fyrus7/FyrusDigitalAlarmClock/DS3231_SQW_Alarm_Clock_FYRUS.ino

const unsigned char PROGMEM FSufi2 [] = {
  0xff, 0xff, 0xff, 0xff, 0xff, 0xf8, 0xff, 0xff, 0xff, 0xff, 0xff, 0xf8, 0xff, 0xff, 0xff, 0xff, 
  0xff, 0xf8, 0xe0, 0x00, 0x00, 0x00, 0x00, 0x38, 0xe0, 0x00, 0x00, 0x00, 0x00, 0x38, 0xe0, 0x00, 
  0x00, 0x00, 0x00, 0x38, 0xe3, 0x8e, 0x3f, 0xe3, 0x8e, 0x38, 0xe3, 0x8e, 0x3f, 0xe3, 0x8e, 0x38, 
  0xe3, 0x8e, 0x3f, 0xe3, 0x8e, 0x38, 0xe3, 0x80, 0x00, 0x00, 0x00, 0x38, 0xe3, 0x80, 0x00, 0x00, 
  0x00, 0x38, 0xe3, 0x80, 0x00, 0x00, 0x00, 0x38, 0xe3, 0x8e, 0x3f, 0xe3, 0xfe, 0x38, 0xe3, 0x8e, 
  0x3f, 0xe3, 0xfe, 0x38, 0xe3, 0x8e, 0x3f, 0xe3, 0xfe, 0x38, 0xe3, 0x8e, 0x38, 0xe3, 0x8e, 0x38, 
  0xe3, 0x8e, 0x38, 0xe3, 0x8e, 0x38, 0xe3, 0x8e, 0x38, 0xe3, 0x8e, 0x38, 0xe3, 0x8e, 0x3f, 0xe3, 
  0xfe, 0x38, 0xe3, 0x8e, 0x3f, 0xe3, 0xfe, 0x38, 0xe3, 0x8e, 0x3f, 0xe3, 0xfe, 0x38, 0xe3, 0x8e, 
  0x00, 0xe0, 0x0e, 0x38, 0xe3, 0x8e, 0x00, 0xe0, 0x0e, 0x38, 0xe3, 0x8e, 0x00, 0xe0, 0x0e, 0x38, 
  0xe3, 0x8e, 0x3f, 0xe3, 0x8e, 0x38, 0xe3, 0x8e, 0x3f, 0xe3, 0x8e, 0x38, 0xe3, 0x8e, 0x3f, 0xe3, 
  0x8e, 0x38, 0xe3, 0x8e, 0x00, 0x03, 0x8e, 0x38, 0xe3, 0x8e, 0x00, 0x03, 0x8e, 0x38, 0xe3, 0x8e, 
  0x00, 0x03, 0x8e, 0x38, 0xe3, 0x8e, 0x3f, 0xff, 0xfe, 0x38, 0xe3, 0x8e, 0x3f, 0xff, 0xfe, 0x38, 
  0xe3, 0x8e, 0x3f, 0xff, 0xfe, 0x38, 0xe3, 0x80, 0x00, 0xe0, 0x00, 0x38, 0xe3, 0x80, 0x00, 0xe0, 
  0x00, 0x38, 0xe3, 0x80, 0x00, 0xe0, 0x00, 0x38, 0xe3, 0xff, 0xff, 0xe3, 0x8e, 0x38, 0xe3, 0xff, 
  0xff, 0xe3, 0x8e, 0x38, 0xe3, 0xff, 0xff, 0xe3, 0x8e, 0x38, 0xe0, 0x00, 0x00, 0x00, 0x00, 0x38, 
  0xe0, 0x00, 0x00, 0x00, 0x00, 0x38, 0xe0, 0x00, 0x00, 0x00, 0x00, 0x38, 0xff, 0xff, 0xff, 0xff, 
  0xff, 0xf8, 0xff, 0xff, 0xff, 0xff, 0xff, 0xf8, 0xff, 0xff, 0xff, 0xff, 0xff, 0xf8
};

// 'Select_Top', 5x3px
const unsigned char Select_Top [] PROGMEM = {
  0x20, 0x70, 0xf8
};

// 'Select_Side', 3x5px
const unsigned char Select_Side [] PROGMEM = {
  0x80, 0xc0, 0xe0, 0xc0, 0x80
};

// 'Select_Buttom', 5x3px
const unsigned char Select_Buttom [] PROGMEM = {
  0xf8, 0x70, 0x20
};


#include "RTClib.h"
#include <TimerOne.h>
#include <LowPower.h>
#include <Adafruit_SSD1306.h>

RTC_DS3231 rtc;

Adafruit_SSD1306 display(128, 64, &Wire, -1);

byte _day, _month, _hour24, _hour12, _minute, _second, _dtw;
int _year;
byte hr24;
char st[2];
char _nameoftheDay[9];
char _monthsName[3];

const char daysOfTheWeek_0[] PROGMEM = "Sunday";   
const char daysOfTheWeek_1[] PROGMEM = "Monday";
const char daysOfTheWeek_2[] PROGMEM = "Tuesday";
const char daysOfTheWeek_3[] PROGMEM = "Wednesday";
const char daysOfTheWeek_4[] PROGMEM = "Thursday";
const char daysOfTheWeek_5[] PROGMEM = "Friday";
const char daysOfTheWeek_6[] PROGMEM = "Saturday";

const char* const daysOfTheWeek_table[] PROGMEM = {
  daysOfTheWeek_0,
  daysOfTheWeek_1,
  daysOfTheWeek_2,
  daysOfTheWeek_3,
  daysOfTheWeek_4,
  daysOfTheWeek_5,
  daysOfTheWeek_6};

const char months_name_0[] PROGMEM = "Jan";   
const char months_name_1[] PROGMEM = "Feb";
const char months_name_2[] PROGMEM = "Mar";
const char months_name_3[] PROGMEM = "Apr";
const char months_name_4[] PROGMEM = "May";
const char months_name_5[] PROGMEM = "Jun";
const char months_name_6[] PROGMEM = "Jul";
const char months_name_7[] PROGMEM = "Aug";
const char months_name_8[] PROGMEM = "Sep";
const char months_name_9[] PROGMEM = "Oct";
const char months_name_10[] PROGMEM = "Nov";
const char months_name_11[] PROGMEM = "Dec";

const char* const months_name_table[] PROGMEM = {
  months_name_0, months_name_1, months_name_2, months_name_3,
  months_name_4, months_name_5, months_name_6, months_name_7,
  months_name_8, months_name_9, months_name_10, months_name_11,};

//--> Variables for Buttons
byte btn_Select, btn_Down;

//--> Variable for SQW pin
const int sqwPin = 2;

//--> Variable for Buzzer
byte Buzzer = 5;
        


// Variables for Menus
bool Menu_Stat = false;
byte Menu_Cnt = 0;
bool Menu_Set = false;
byte Menu_Set_cnt;
byte Menu_Set_TimeDate = 0;

bool set_Hour = false;
bool set_Minute = false;
bool set_Day = false;
bool set_Month = false;
bool set_Year = false;

bool blink_cursor = false;
int _delay = 100;

// Alarm 1
byte Alarm_Stat = 0;
bool Set_hour_alarm = false;
bool Set_minute_alarm = false;
byte Menu_Set_Alarm = 0;
bool Alarm_Sound = false;
bool Alarm_Start = false;
byte Alarm_Duration = 0;
bool Blink_Alarm_Display = false;

// Alarm 2
byte Alarm_Stat2 = 0;
bool Set_hour_alarm2 = false;
bool Set_minute_alarm2 = false;
byte Menu_Set_Alarm2 = 0;
bool Alarm_Sound2 = false;
bool Alarm_Start2 = false;
byte Alarm_Duration2 = 0;
bool Blink_Alarm_Display2 = false;


// Variables for Millis to update Time and Date. Also for the Alarm interval
unsigned long previousMillisGetTimeDate = 0; //--> will store last time was updated
const long intervalGetTimeDate = 1000; //--> interval (milliseconds) 


const unsigned long sleepTimeout = 15000; // 15 second to sleep mode
volatile unsigned long lastActivityTime = 0; // Declare as volatile for ISR safety
const int CRT_display = 300; // CRT Off Animation duration in milliseconds


void wakeUp(){
  // let this empty
}

void timerISR() {
  // let this empty
}


void setup() {
  //Serial.begin(9600);

  pinMode(3, INPUT_PULLUP);
  pinMode(6, INPUT_PULLUP);
  pinMode(sqwPin, INPUT_PULLUP);

  pinMode(Buzzer, OUTPUT);

  rtc.begin();
/*
  if (! rtc.begin()) {
   // Serial.println("Couldn't find RTC");
   // Serial.flush();
    while (1);
  }*/
/*
  if (rtc.lostPower()) {
   // Serial.println("RTC lost power, let's set the time!");
   // rtc.adjust(DateTime(F(__DATE__), F(__TIME__)));
  }*/


  rtc.disable32K(); // disable 32K Pin

  rtc.disableAlarm(1);
  rtc.disableAlarm(2);
  rtc.clearAlarm(1);
  rtc.clearAlarm(2);

  rtc.writeSqwPinMode(DS3231_OFF); // Place SQW pin into alarm interrupt mode

  display.begin(SSD1306_SWITCHCAPVCC, 0x3C);
  display.clearDisplay();

  display.drawBitmap(3, 10, FSufi2, 45, 45, WHITE);
  display.setTextColor(WHITE);
  display.setTextSize(1);
  display.setCursor(55, 10);
  display.print(F("== FYRUS =="));
  display.setCursor(55, 38);
  display.print(F("DS3231 RTC"));
  display.setCursor(55, 48);
  display.print(F("Alarm Clock"));

  display.display();
  delay(3000);

  // Set up TimerOne to call the timerISR function every 1 second
  Timer1.initialize(1000000); // 1 second interval
  Timer1.attachInterrupt(timerISR);

}


void loop() {

  
  // To update the Time and Date
  unsigned long currentMillisGetTimeDate = millis();
  if (currentMillisGetTimeDate - previousMillisGetTimeDate >= intervalGetTimeDate) {
    // save the last time you blinked the LED
    previousMillisGetTimeDate = currentMillisGetTimeDate;

    // Time and Date are displayed if Menu Status = False
    if (Menu_Stat == false) {
      GetDateTime();
 

      display.clearDisplay();


      if (Alarm_Stat == 1 && Alarm_Stat2 == 1){
        Alarm_Start = true;
        Alarm_Start2 = true;

        display.setCursor(85, 0);
        DateTime alarmTime = rtc.getAlarm1();

        display.write(0x0E); display.print(F(" "));

        if (alarmTime.hour() < 10) {
          display.print(F("0"));
          display.print(alarmTime.hour());
        } else {
          display.print(alarmTime.hour());
        }
          display.print(F(":"));
        if (alarmTime.minute() < 10) {
          display.print(F("0"));
          display.print(alarmTime.minute());
        } else {
          display.print(alarmTime.minute());
        }

        display.setCursor(2, 56);
        DateTime alarmTime2 = rtc.getAlarm2();

        display.write(0x0E); display.print(F(" "));

        if (alarmTime2.hour() < 10) {
          display.print(F("0"));
          display.print(alarmTime2.hour());
        } else {
          display.print(alarmTime2.hour());
        }
          display.print(F(":"));
        if (alarmTime2.minute() < 10) {
          display.print(F("0"));
          display.print(alarmTime2.minute());
        } else {
          display.print(alarmTime2.minute());
        }
        
        //display.setCursor(110, 0); display.write(0x0E); display.write(0x0E);
        
      } else if (Alarm_Stat2 == 1){
        Alarm_Start2 = true;
        
        display.setCursor(85, 0);
        DateTime alarmTime2 = rtc.getAlarm2();

        display.write(0x0E); display.print(F(" "));

        if (alarmTime2.hour() < 10) {
          display.print(F("0"));
          display.print(alarmTime2.hour());
        } else {
          display.print(alarmTime2.hour());
        }
          display.print(F(":"));
        if (alarmTime2.minute() < 10) {
          display.print(F("0"));
          display.print(alarmTime2.minute());
        } else {
          display.print(alarmTime2.minute());
        }
        //display.setCursor(120, 0); display.write(0x0E);

      } else if (Alarm_Stat == 1) {
        Alarm_Start = true;

        display.setCursor(85, 0);
        DateTime alarmTime = rtc.getAlarm1();

        display.write(0x0E); display.print(F(" "));

        if (alarmTime.hour() < 10) {
          display.print(F("0"));
          display.print(alarmTime.hour());
        } else {
          display.print(alarmTime.hour());
        }
          display.print(F(":"));
        if (alarmTime.minute() < 10) {
          display.print(F("0"));
          display.print(alarmTime.minute());
        } else {
          display.print(alarmTime.minute());
        }
        //display.setCursor(120, 0); display.write(0x0E);
      }
      


      char buff[] = "hh:mm";

      // A condition that is executed if the Alarm 1 starts and stops
        if (digitalRead(sqwPin) == LOW){

          display.clearDisplay();

        Alarm_Start = true;
        Alarm_Sound = !Alarm_Sound;
        if (Alarm_Sound == true) {
          Button_Sound(1);
        } else {
          Button_Sound(0);
        }

        Alarm_Duration++;
        // Change the value 59 to increase or decrease the Alarm 1 duration
        if (Alarm_Duration > 179) {
          rtc.disableAlarm(1);
          Button_Sound(0);
          Alarm_Duration = 0;
          Alarm_Start = false;
        }

        display.setTextSize(2);
        Blink_Alarm_Display = !Blink_Alarm_Display;
        if (Blink_Alarm_Display == true) {
          display.setTextColor(WHITE);
        } else {
          display.setTextColor(BLACK);
        }
      
        display.setCursor(35, 20);
        display.setTextSize(2);
        display.print(F("ALARM"));
        display.setCursor(35, 42);

        DateTime now = rtc.now();
        display.print(now.toString(buff));

      }
      
      
      
      // A condition that is executed if the Alarm 2 starts and stops
        if (digitalRead(sqwPin) == LOW){

          display.clearDisplay();

        Alarm_Start2 = true;
        Alarm_Sound2 = !Alarm_Sound2;
        if (Alarm_Sound2 == true) {
          Button_Sound2(1);
        } else {
          Button_Sound2(0);
        }

        Alarm_Duration2++;
        // Change the value 59 to increase or decrease the Alarm 2 duration
        if (Alarm_Duration2 > 179) {
          rtc.disableAlarm(2);
          Button_Sound2(0);
          Alarm_Duration2 = 0;
          Alarm_Start2 = false;
        }

        display.setTextSize(2);
        Blink_Alarm_Display2 = !Blink_Alarm_Display2;
        if (Blink_Alarm_Display2 == true) {
          display.setTextColor(WHITE);
        } else {
          display.setTextColor(BLACK);
        }
      
        display.setCursor(35, 20);
        display.setTextSize(2);
        display.print(F("ALARM"));
        display.setCursor(35, 42);

        DateTime now = rtc.now();
        display.print(now.toString(buff));

      } else {
        //Digital_Clock_and_Date(_hour24, _minute, _second, _dtw, _day, _month ,_year);
        Digital_Clock_and_Date(_hour12, _minute, _second, _dtw, _day, _month ,_year);
      }
      
      display.display();
    }
  }


  read_button();

  // BUTTON USE to Stop the Alarm
  if (btn_Down == LOW || btn_Select == LOW && Alarm_Start == true) {
    rtc.clearAlarm(1);
    Button_Sound(0);
    Alarm_Start = false;
    Alarm_Duration = 0;
    read_button();
  }


  if (btn_Down == LOW || btn_Select == LOW && Alarm_Start2 == true) {
    rtc.clearAlarm(2);
    Button_Sound2(0);
    Alarm_Start2 = false;
    Alarm_Duration2 = 0;
    read_button();
  }


  // Conditions for displaying to the Menu
  if (btn_Down == LOW && btn_Select == LOW && Menu_Stat == false) {
    delay(500);
    Menu_Cnt = 1;
    Menu_Stat = true;
  }

  
  // Looping to display Menu
  while (Menu_Stat == true) {
    read_button();
    // Button Condition for selecting Setup Menu
    if (btn_Down == LOW) {
      delay(100);
      Menu_Cnt++;
      if (Menu_Cnt > 4) Menu_Cnt = 1;
    }

    if (btn_Select == LOW && Menu_Cnt == 1) {
      delay(500);
      Menu_Set = true;
      Menu_Set_cnt = 1;
      Menu_Set_Alarm = 1;      
    }
  
    if (btn_Select == LOW && Menu_Cnt == 2) {
      delay(500);
      Menu_Set = true;
      Menu_Set_cnt = 2;
      Menu_Set_Alarm2 = 1;
    }

    if (btn_Select == LOW && Menu_Cnt == 3) {
      delay(500);
      Menu_Set = true;
      Menu_Set_cnt = 3;
      Menu_Set_TimeDate = 1;
    }

    if (btn_Select == LOW && Menu_Cnt == 4) {
      delay(500);
      Menu_Cnt = 1;
      Menu_Stat = false;
    }


    // Conditions for displaying Menu contents
    if (Menu_Cnt == 1) {
      Menu_Display(Menu_Cnt);
    } else if (Menu_Cnt == 2) {
      Menu_Display(Menu_Cnt);
    } else if (Menu_Cnt == 3) {
      Menu_Display(Menu_Cnt);
    } if (Menu_Cnt == 4) {
      Menu_Display(Menu_Cnt);
    } 


    // Looping for Time and Date Setting Menu
    while (Menu_Set == true && Menu_Set_cnt == 1) {
      Set_Alarm();
      delay(50);
    }

    // Looping for Alarm Settings Menu
    while (Menu_Set == true && Menu_Set_cnt == 2) {
      Set_Alarm2();
      delay(50);
    }

    while (Menu_Set == true && Menu_Set_cnt == 3) {
      Set_Time_Date();
      delay(50);
    }
    delay(50);
  }

  // Check if it's time to sleep when no button is pressed.
  if (millis() - lastActivityTime > sleepTimeout) {
    displayOff();
    Timer1.stop();
    sleep();
    Timer1.start();
  }
}


void displayOff() { // turn display off when sleep.
  unsigned long CRTStartTime = millis();
  while (millis() - CRTStartTime <= CRT_display) {
    int width = map(millis() - CRTStartTime, 0, CRT_display, 128, 0);
    display.clearDisplay();
    display.fillRect((128 - width) / 2, 64 / 2, width, 2, SSD1306_WHITE);   
    display.display();
  }
  display.ssd1306_command(SSD1306_DISPLAYOFF);
}

void sleep() { // sleep forever until interrupt been pressed.
  attachInterrupt(digitalPinToInterrupt(3), wakeUp, FALLING);
  attachInterrupt(digitalPinToInterrupt(sqwPin), wakeUp, FALLING);
  LowPower.powerDown(SLEEP_FOREVER, ADC_OFF, BOD_OFF);
  display.ssd1306_command(SSD1306_DISPLAYON);
}


// Subroutines for reading Buttons
void read_button() {
  btn_Select = digitalRead(6);
  btn_Down = digitalRead(3);

  if (btn_Select == LOW || btn_Down == LOW || digitalRead(sqwPin) == LOW){
    lastActivityTime = millis();
  }
}


void GetDateTime(){
  DateTime now = rtc.now();
  _day    = now.day();
  _month  = now.month();
  _year   = now.year();
  _hour24 = now.hour();
  _minute = now.minute();
  _second = now.second();
  _dtw    = now.dayOfTheWeek();

  hr24=_hour24;
  if (hr24>12) {
    _hour12=hr24-12;
  }
  else if (hr24==0) {
    _hour12=12;
  }
  else {
    _hour12=hr24;
  }

  if (hr24<12) {
    strcpy(st, "AM");
  }
  else {
    strcpy(st, "PM");
  } 
}



// Subroutines for displaying Digital Clock and Date
void Digital_Clock_and_Date(byte h, byte m, byte s, byte dtw, byte dy, byte mt, int yr) {

  display.drawLine(0, 12, 128, 12, SSD1306_WHITE);
  display.drawLine(0, 50, 128, 50, SSD1306_WHITE);

  display.setTextColor(WHITE);

  display.setTextSize(3);
  display.setCursor(5, 20);
  if (h < 10) {
    display.print(F("0"));
    display.print(h);
  } else {
    display.print(h);
  }
  display.setTextSize(2);
  display.print(F(":"));
  display.setTextSize(3);
  if (m < 10) {
    display.print(F("0"));
    display.print(m);
  } else {
    display.print(m);
  }
  display.setTextSize(2);
  display.print(F(":"));
  if (s < 10) {
    display.print(F("0"));
    display.print(s);
  } else {
    display.print(s);
  }

  display.setCursor(102, 38);
  display.setTextSize(1);
  if (hr24 < 12) {
    display.print(F("AM"));
  } else {
    display.print(F("PM"));
  }



  // To display Day Name
  if (Menu_Stat == false) {
    strcpy_P(_nameoftheDay,(char*)pgm_read_word(&(daysOfTheWeek_table[dtw])));
    byte display_center_area = (127 - 65) / 2;
    byte center_text = (strlen(_nameoftheDay) * 6) / 2;
    display.setTextSize(1);
    display.setCursor(2, 0);
    display.println(_nameoftheDay); 
  }

  // To display the Date
  display.setTextSize(1);
  strcpy_P(_monthsName,(char*)pgm_read_word(&(months_name_table[mt-1])));
  display.setCursor(55, 56);
  if (dy < 10) {
    display.print(F("0"));
    display.print(dy);
  } else {
    display.print(dy);
  }
  display.print(F(", "));
  display.print(_monthsName);
  display.print(F(" "));
  display.print(yr);
}


// Subroutine to display Menu Display
void Menu_Display(byte slct) {
  display.clearDisplay();
  
  display.setTextSize(1);
  display.setTextColor(WHITE);

  display.setCursor(34, 0);
  display.print(F("-- MENU --"));

  display.setCursor(7, 20);
  display.print(F("Set Alarm 1"));

  display.setCursor(7, 30);
  display.print(F("Set Alarm 2"));

  display.setCursor(7, 40);
  display.print(F("Set Time and Date"));

  display.setCursor(7, 55);
  display.print(F("Back"));

  // Conditions for the cursor position on the Menu
  if (slct == 1) {
    display.drawBitmap(0, 20, Select_Side, 3, 5, WHITE);
  } else if (slct == 2) {
    display.drawBitmap(0, 30, Select_Side, 3, 5, WHITE);
  } else if (slct == 3) {
    display.drawBitmap(0, 40, Select_Side, 3, 5, WHITE);
  } else if (slct == 4) {
    display.drawBitmap(0, 55, Select_Side, 3, 5, WHITE);
  }

  display.display();
}


// Subroutines for SET Clock and Date
void Set_Clock_and_Date(byte h, byte m, byte s, byte dy, byte mt, int yr) {

  display.setTextColor(WHITE);

  display.setTextSize(2);
  display.setCursor(35, 18);
  if (h < 10) {
    display.print(F("0"));
    display.print(h);
  } else {
    display.print(h);
  }
  display.print(F(":"));
  if (m < 10) {
    display.print(F("0"));
    display.print(m);
  } else {
    display.print(m);
  }


  // To display the Date
  display.setTextSize(1);
  strcpy_P(_monthsName,(char*)pgm_read_word(&(months_name_table[mt-1])));
  display.setCursor(20, 36);
  if (dy < 10) {
    display.print(F("0"));
    display.print(dy);
  } else {
    display.print(dy);
  }
  display.print(F(" / "));
  display.print(_monthsName);
  display.print(F(" / "));
  display.print(yr);
}


// Subroutines for displaying Time and Date settings
void Set_Time_Date() {

  read_button();

  display.clearDisplay();
  
  Set_Clock_and_Date(_hour24, _minute, _second, _day, _month ,_year);

  display.setTextSize(1);

  display.setCursor(13, 0);
  display.print(F("-- TIME & DATE --"));

  display.setCursor(28, 56);
  display.print(F("Save"));
  
  display.setCursor(80, 56);
  display.print(F("Back"));


  if (btn_Down == LOW) {
    delay(100);
    Menu_Set_TimeDate++;
    if (Menu_Set_TimeDate > 7) Menu_Set_TimeDate = 1;
  }

  if (btn_Select == LOW && Menu_Set_TimeDate == 1) {
    delay(500);
    set_Hour = true;
  }

  if (btn_Select == LOW && Menu_Set_TimeDate == 2) {
    delay(500);
    set_Minute = true;
  }

  if (btn_Select == LOW && Menu_Set_TimeDate == 3) {
    delay(500);
    set_Day = true;
  }

  if (btn_Select == LOW && Menu_Set_TimeDate == 4) {
    delay(500);
    set_Month = true;
  }

  if (btn_Select == LOW && Menu_Set_TimeDate == 5) {
    delay(500);
    set_Year = true;
  }

  if (btn_Select == LOW && Menu_Set_TimeDate == 6) {
    delay(500);
    rtc.adjust(DateTime(_year, _month, _day, _hour24, _minute, 0));
    Display_to_save();
  }


  if (btn_Select == LOW && Menu_Set_TimeDate == 7) {
    delay(100);
    Menu_Set_cnt = 0;
    Menu_Set = false;
    Menu_Stat = false; // remove to go back to Menu
  }


  // Conditions for the cursor position
  if (Menu_Set_TimeDate == 1) {
    Set_Time_Date_Display(Menu_Set_TimeDate);
  } else if (Menu_Set_TimeDate == 2) {
    Set_Time_Date_Display(Menu_Set_TimeDate);
  } else if (Menu_Set_TimeDate == 3) {
    Set_Time_Date_Display(Menu_Set_TimeDate);
  } else if (Menu_Set_TimeDate == 4) {
    Set_Time_Date_Display(Menu_Set_TimeDate);
  } else if (Menu_Set_TimeDate == 5) {
    Set_Time_Date_Display(Menu_Set_TimeDate);
  } else if (Menu_Set_TimeDate == 6) {
    Set_Time_Date_Display(Menu_Set_TimeDate);
  } else if (Menu_Set_TimeDate == 7) {
    Set_Time_Date_Display(Menu_Set_TimeDate);
  } 

  display.display();

  // Looping to set Hour
  while (set_Hour == true) {
    read_button();
    display.clearDisplay();

    display.setCursor(13, 0);
    display.print(F("-- TIME & DATE --"));

    Set_Clock_and_Date(_hour24, _minute, _second, _day, _month ,_year);

    if (btn_Down == LOW) {
      _delay = 50;
      delay(_delay);
      _hour24++;
      if (_hour24 > 23) _hour24 = 0;
    }

    if (btn_Select == LOW) {
      delay(500);
      set_Hour = false;
    }

    if (btn_Down == HIGH && btn_Select == HIGH) {
      _delay = 100;
    }

    blink_cursor = !blink_cursor;
    if (blink_cursor == true) {
      display.fillRect(35, 19, 25, 18, BLACK);
    }
    
    display.display();
    delay(_delay);
  }


  // Looping to set Minute
  while (set_Minute == true) {
    read_button();
    display.clearDisplay();

    display.setCursor(13, 0);
    display.print(F("-- TIME & DATE --"));

    Set_Clock_and_Date(_hour24, _minute, _second, _day, _month ,_year);

    if (btn_Down == LOW) {
      _delay = 50;
      delay(_delay);
      _minute++;
      if (_minute > 59) _minute = 0;
    }

    if (btn_Select == LOW) {
      delay(500);
      set_Minute = false;
    }

    if (btn_Down == HIGH && btn_Select == HIGH) {
      _delay = 100;
    }

    blink_cursor = !blink_cursor;
    if (blink_cursor == true) {
      display.fillRect(70, 19, 25, 18, BLACK);
    }
    
    display.display();
    delay(_delay);
  }


  // Looping to set Day / Date
  while (set_Day == true) {
    read_button();
    display.clearDisplay();

    display.setCursor(13, 0);
    display.print(F("-- TIME & DATE --"));

    Set_Clock_and_Date(_hour24, _minute, _second, _day, _month ,_year);

    if (btn_Down == LOW) {
      _delay = 50;
      delay(_delay);
      _day++;
      if (_day > 31) _day = 1;
    }

    if (btn_Select == LOW) {
      delay(500);
      set_Day = false;
    }

    if (btn_Down == HIGH && btn_Select == HIGH) {
      _delay = 100;
    }

    blink_cursor = !blink_cursor;
    if (blink_cursor == true) {
      display.fillRect(20, 37, 12, 8, BLACK);
    }
    
    display.display();
    delay(_delay);
  }


  // Looping to set Month
  while (set_Month == true) {
    read_button();
    display.clearDisplay();

    display.setCursor(13, 0);
    display.print(F("-- TIME & DATE --"));

    Set_Clock_and_Date(_hour24, _minute, _second, _day, _month ,_year);

    if (btn_Down == LOW) {
      _delay = 50;
      delay(_delay);
      _month++;
      if (_month > 12) _month = 1;
    }

    if (btn_Select == LOW) {
      delay(500);
      set_Month = false;
    }

    if (btn_Down == HIGH && btn_Select == HIGH) {
      _delay = 100;
    }

    blink_cursor = !blink_cursor;
    if (blink_cursor == true) {
      display.fillRect(50, 37, 20, 8, BLACK);
    }
    
    display.display();
    delay(_delay);
  }


  // Looping to set Year
  while (set_Year == true) {
    read_button();
    display.clearDisplay();

    display.setCursor(13, 0);
    display.print(F("-- TIME & DATE --"));

    Set_Clock_and_Date(_hour24, _minute, _second, _day, _month ,_year);

    if (btn_Down == LOW) {
      _delay = 50;
      delay(_delay);
      _year++;
      if (_year > 2100) _year = 2000;
    }

    if (btn_Select == LOW) {
      delay(500);
      set_Year = false;
    }

    if (btn_Down == HIGH && btn_Select == HIGH) {
      _delay = 100;
    }

    blink_cursor = !blink_cursor;
    if (blink_cursor == true) {
      display.fillRect(98, 37, 12, 8, BLACK);
    }
    
    display.display();
    delay(_delay);
  }
}

// Subroutines for displaying a cursor to select settings
void Set_Time_Date_Display(byte slc) {
   display.setTextSize(1);
   display.setTextColor(WHITE);
    
  if (slc == 1) {
    //Set Hour
    display.drawBitmap(45, 12, Select_Buttom, 5, 3, WHITE);
  } else if (slc == 2) {
    //Set Minute
    display.drawBitmap(80, 12, Select_Buttom, 5, 3, WHITE);
  } else if (slc == 3) {
    //Set Day
    display.drawBitmap(22, 47, Select_Top, 5, 3, WHITE);
  } else if (slc == 4) {
    //Set Month
    display.drawBitmap(56, 47, Select_Top, 5, 3, WHITE);
  } else if (slc == 5) {
    //Set Year
    display.drawBitmap(102, 47, Select_Top, 5, 3, WHITE);
  } else if (slc == 6) {
    //Save Settings
    display.drawBitmap(20, 58, Select_Side, 3, 5, WHITE);
  } else if (slc == 7) {
    //Back
    display.drawBitmap(72, 58, Select_Side, 3, 5, WHITE);
  }
}


void setAlarmTime(int hour, int minute) {
  rtc.disableAlarm(1);
  rtc.clearAlarm(1);

  DateTime now = rtc.now();
  DateTime alarmTime(now.year(), now.month(), now.day(), hour, minute, 0);

  if (alarmTime < now) {
    // If the alarm time is in the past, set it for the next day
    alarmTime = alarmTime + TimeSpan(1, 0, 0, 0);
  }
  rtc.setAlarm1(alarmTime, DS3231_A1_Hour);
}



// Subroutines for Alarm Settings
void Set_Alarm() {
  read_button();
  
  display.clearDisplay();

  display.setTextSize(1);
  display.setTextColor(WHITE);

  Set_Alarm_Display();

  if (btn_Down == LOW) {
    delay(100);
    Menu_Set_Alarm++;
    if (Menu_Set_Alarm > 5) Menu_Set_Alarm = 1;
  }

  if (btn_Select == LOW && Menu_Set_Alarm == 1) {
    delay(250);
    Set_hour_alarm = true;
  }

  if (btn_Select == LOW && Menu_Set_Alarm == 2) {
    delay(250);
    Set_minute_alarm = true;
  }

  // Button Condition to enable Alarm and save Alarm settings
  if (btn_Select == LOW && Menu_Set_Alarm == 3) { // enable alarm
    delay(500);
    
    Display_to_save();

    Alarm_Stat = 1;
    delay(100);
  }


  // Button Condition to disable Alarm
  if (btn_Select == LOW && Menu_Set_Alarm == 4) { // disable alarm
    delay(500);
    // Disable and clear alarm
    rtc.disableAlarm(1);
    rtc.clearAlarm(1);
    
    Display_to_save();
    
    Alarm_Stat = 0;
    delay(100);
  }


  if (btn_Select == LOW && Menu_Set_Alarm == 5) {
    delay(500);
    Menu_Set_Alarm = 0;
    Menu_Stat = false; // remove to go back to Menu
    Menu_Set = false;
  }


  // Conditions for displaying the cursor position on the Alarm Settings
  if (Menu_Set_Alarm == 1) {
    Set_Alarm_Cursor(Menu_Set_Alarm);
  } else if (Menu_Set_Alarm == 2) {
    Set_Alarm_Cursor(Menu_Set_Alarm);
  } else if (Menu_Set_Alarm == 3) {
    Set_Alarm_Cursor(Menu_Set_Alarm);
  } else if (Menu_Set_Alarm == 4) {
    Set_Alarm_Cursor(Menu_Set_Alarm);
  } else if (Menu_Set_Alarm == 5) {
    Set_Alarm_Cursor(Menu_Set_Alarm);
  } 


  // Looping for setting the Hour for Alarm
  while (Set_hour_alarm == true && Menu_Set_Alarm == 1) {
    read_button();
    
    display.clearDisplay();

    if (btn_Down == LOW) {
      DateTime alarmTime = rtc.getAlarm1();
      _delay = 50;
      delay(_delay);
      int newHour = (alarmTime.hour() + 1) % 24;
      setAlarmTime(newHour, alarmTime.minute());
    }

    if (btn_Select == LOW) {
      delay(500);
      Set_hour_alarm = false;
    }

    if (btn_Down == HIGH && btn_Select == HIGH) {
      _delay = 100;
    }

    Set_Alarm_Display();

    blink_cursor = !blink_cursor;
    if (blink_cursor == true) {
      display.fillRect(35, 10, 25, 20, BLACK);
    }

    display.display();
    delay(_delay);
  }


  // Looping for setting the Minute for Alarm
  while (Set_minute_alarm == true && Menu_Set_Alarm == 2) {
    read_button();
    
    display.clearDisplay();

    if (btn_Down == LOW) {
      DateTime alarmTime = rtc.getAlarm1();
      _delay = 50;
      delay(_delay);
      int newMinute = (alarmTime.minute() + 1) % 60;
      setAlarmTime(alarmTime.hour(), newMinute);
    }

    if (btn_Select == LOW) {
      delay(500);
      Set_minute_alarm = false;
    }

    if (btn_Down == HIGH && btn_Select == HIGH) {
      _delay = 100;
    }

    Set_Alarm_Display();

    blink_cursor = !blink_cursor;
    if (blink_cursor == true) {
      display.fillRect(70, 10, 25, 20, BLACK);
    }

    display.display();
    delay(_delay);
  }
  
  display.display();
}



// Subroutines for the Alarm Settings display
void Set_Alarm_Display() {

  if (Alarm_Stat == 0) {
    display.setTextSize(1);
    display.setCursor(86, 35);
    display.print(F("Alarm 1"));
    display.setTextSize(2);
    display.setCursor(90, 46);
    display.print(F("OFF"));
  } else {
    display.setCursor(86, 35);
    display.print(F("Alarm 1"));
    display.setTextSize(2);
    display.setCursor(95, 46);
    display.print(F("ON"));
  }


  //DateTime now = rtc.now();
  DateTime alarmTime = rtc.getAlarm1();

  display.setTextSize(2);

  if (alarmTime.hour() < 10) {
    display.setCursor(35, 10);
    display.print(F("0"));
    display.print(alarmTime.hour(), DEC);
  } else {
    display.setCursor(35, 10);
    display.print(alarmTime.hour(), DEC);
  }
  display.print(F(":"));
  if (alarmTime.minute() < 10) {
    display.print(F("0"));
    display.print(alarmTime.minute(), DEC);
  } else {
    display.print(alarmTime.minute(), DEC);
  }

  display.setTextSize(1);
  display.setCursor(7, 35);
  display.print(F("Enable"));

  display.setCursor(7, 45);
  display.print(F("Disable"));

  display.setCursor(7, 55);
  display.print(F("Back"));
}



void setAlarmTime2(int hour, int minute) {
  rtc.disableAlarm(2);
  rtc.clearAlarm(2);

  DateTime now = rtc.now();
  DateTime alarmTime2(now.year(), now.month(), now.day(), hour, minute, 0);

  if (alarmTime2 < now) {
    // If the alarm time is in the past, set it for the next day
    alarmTime2 = alarmTime2 + TimeSpan(1, 0, 0, 0);
  }
  rtc.setAlarm2(alarmTime2, DS3231_A2_Hour);
}



// Subroutines for Alarm Settings
void Set_Alarm2() {
  read_button();
  
  display.clearDisplay();

  display.setTextSize(1);
  display.setTextColor(WHITE);

  Set_Alarm_Display2();

  if (btn_Down == LOW) {
    delay(100);
    Menu_Set_Alarm2++;
    if (Menu_Set_Alarm2 > 5) Menu_Set_Alarm2 = 1;
  }

  if (btn_Select == LOW && Menu_Set_Alarm2 == 1) {
    delay(250);
    Set_hour_alarm2 = true;
  }

  if (btn_Select == LOW && Menu_Set_Alarm2 == 2) {
    delay(250);
    Set_minute_alarm2 = true;
  }

  // Button Condition to enable Alarm and save Alarm settings
  if (btn_Select == LOW && Menu_Set_Alarm2 == 3) { // enable alarm
    delay(500);
    
    Display_to_save();

    Alarm_Stat2 = 1;
    delay(100);
  }


  // Button Condition to disable Alarm
  if (btn_Select == LOW && Menu_Set_Alarm2 == 4) { // disable alarm
    delay(500);
    // Disable and clear alarm
    rtc.disableAlarm(2);
    rtc.clearAlarm(2);
    
    Display_to_save();
    
    Alarm_Stat2 = 0;
    delay(100);
  }


  if (btn_Select == LOW && Menu_Set_Alarm2 == 5) {
    delay(500);
    Menu_Set_Alarm2 = 0;
    Menu_Stat = false; // remove to go back to Menu
    Menu_Set = false;
  }


  // Conditions for displaying the cursor position on the Alarm Settings
  if (Menu_Set_Alarm2 == 1) {
    Set_Alarm_Cursor(Menu_Set_Alarm2);
  } else if (Menu_Set_Alarm2 == 2) {
    Set_Alarm_Cursor(Menu_Set_Alarm2);
  } else if (Menu_Set_Alarm2 == 3) {
    Set_Alarm_Cursor(Menu_Set_Alarm2);
  } else if (Menu_Set_Alarm2 == 4) {
    Set_Alarm_Cursor(Menu_Set_Alarm2);
  } else if (Menu_Set_Alarm2 == 5) {
    Set_Alarm_Cursor(Menu_Set_Alarm2);
  } 


  // Looping for setting the Hour for Alarm
  while (Set_hour_alarm2 == true && Menu_Set_Alarm2 == 1) {
    read_button();
    
    display.clearDisplay();

    if (btn_Down == LOW) {
      DateTime alarmTime2 = rtc.getAlarm2();
      _delay = 50;
      delay(_delay);
      int newHour = (alarmTime2.hour() + 1) % 24;
      setAlarmTime2(newHour, alarmTime2.minute());
    }

    if (btn_Select == LOW) {
      delay(500);
      Set_hour_alarm2 = false;
    }

    if (btn_Down == HIGH && btn_Select == HIGH) {
      _delay = 100;
    }

    Set_Alarm_Display2();

    blink_cursor = !blink_cursor;
    if (blink_cursor == true) {
      display.fillRect(35, 10, 25, 20, BLACK);
    }

    display.display();
    delay(_delay);
  }


  // Looping for setting the Minute for Alarm
  while (Set_minute_alarm2 == true && Menu_Set_Alarm2 == 2) {
    read_button();
    
    display.clearDisplay();

    if (btn_Down == LOW) {
      DateTime alarmTime2 = rtc.getAlarm2();
      _delay = 50;
      delay(_delay);
      int newMinute = (alarmTime2.minute() + 1) % 60;
      setAlarmTime2(alarmTime2.hour(), newMinute);
    }

    if (btn_Select == LOW) {
      delay(500);
      Set_minute_alarm2 = false;
    }

    if (btn_Down == HIGH && btn_Select == HIGH) {
      _delay = 100;
    }

    Set_Alarm_Display2();

    blink_cursor = !blink_cursor;
    if (blink_cursor == true) {
      display.fillRect(70, 10, 25, 20, BLACK);
    }

    display.display();
    delay(_delay);
  }
  
  display.display();
}



// Subroutines for the Alarm Settings display
void Set_Alarm_Display2() {

  if (Alarm_Stat2 == 0) {
    display.setTextSize(1);
    display.setCursor(86, 35);
    display.print(F("Alarm 2"));
    display.setTextSize(2);
    display.setCursor(90, 46);
    display.print(F("OFF"));
  } else {
    display.setCursor(86, 35);
    display.print(F("Alarm 2"));
    display.setTextSize(2);
    display.setCursor(95, 46);
    display.print(F("ON"));
  }



  //DateTime now = rtc.now();
  DateTime alarmTime2 = rtc.getAlarm2();

  display.setTextSize(2);

  if (alarmTime2.hour() < 10) {
    display.setCursor(35, 10);
    display.print(F("0"));
    display.print(alarmTime2.hour(), DEC);
  } else {
    display.setCursor(35, 10);
    display.print(alarmTime2.hour(), DEC);
  }
  display.print(F(":"));
  if (alarmTime2.minute() < 10) {
    display.print(F("0"));
    display.print(alarmTime2.minute(), DEC);
  } else {
    display.print(alarmTime2.minute(), DEC);
  }

  display.setTextSize(1);
  display.setCursor(7, 35);
  display.print(F("Enable"));

  display.setCursor(7, 45);
  display.print(F("Disable"));

  display.setCursor(7, 55);
  display.print(F("Back"));
}




// Subroutines for display and cursor position in Alarm Settings
void Set_Alarm_Cursor(byte slc) {
  if (slc == 1) {
    display.drawBitmap(45, 0, Select_Buttom, 5, 3, WHITE);
  } else if (slc == 2) {
    display.drawBitmap(80, 0, Select_Buttom, 5, 3, WHITE);
  } else if (slc == 3) {
    display.drawBitmap(0, 35, Select_Side, 3, 5, WHITE);
  } else if (slc == 4) {
    display.drawBitmap(0, 45, Select_Side, 3, 5, WHITE);
  } else if (slc == 5) {
    display.drawBitmap(0, 55, Select_Side, 3, 5, WHITE);
  } 
}
/*
void ResetAlarm() {
  DateTime alarmTime = rtc.getAlarm1();
}
*/
// Subroutine to display the Save
void Display_to_save() {
  display.clearDisplay(); 
  
  display.setTextSize(2);
  display.setTextColor(WHITE);
  display.setCursor(33, 24);
  display.print(F("Saved"));
  
  display.display();

  delay(500);
}


// Subroutines to turn the Buzzer on or off
void Button_Sound(byte snd) {
  digitalWrite(Buzzer, snd);
}

void Button_Sound2(byte snd) {
  digitalWrite(Buzzer, snd);
}
