fyrus7/FyrusDigitalAlarmClock/(commit log)

2024-01-21 the Schematic
2024-01-22 still fixing the snooze
    [FyrusDigitalAlarmClock.ino]
